blaizard/jardinier2000/README.md

# Jardinier 2000

# Getting started

To initialize and deploy the server, simply run:
```bash
./app.py update
./app.py init
./app.py start prod
```
