blaizard/jardinier2000/(list of files, cad)

Other CAD files:
nodes/water-provider/threads.scad
