blaizard/jardinier2000/nodes/observer/observer.brd

## EAGLE design nodes/observer/observer.brd (2019-12-02)

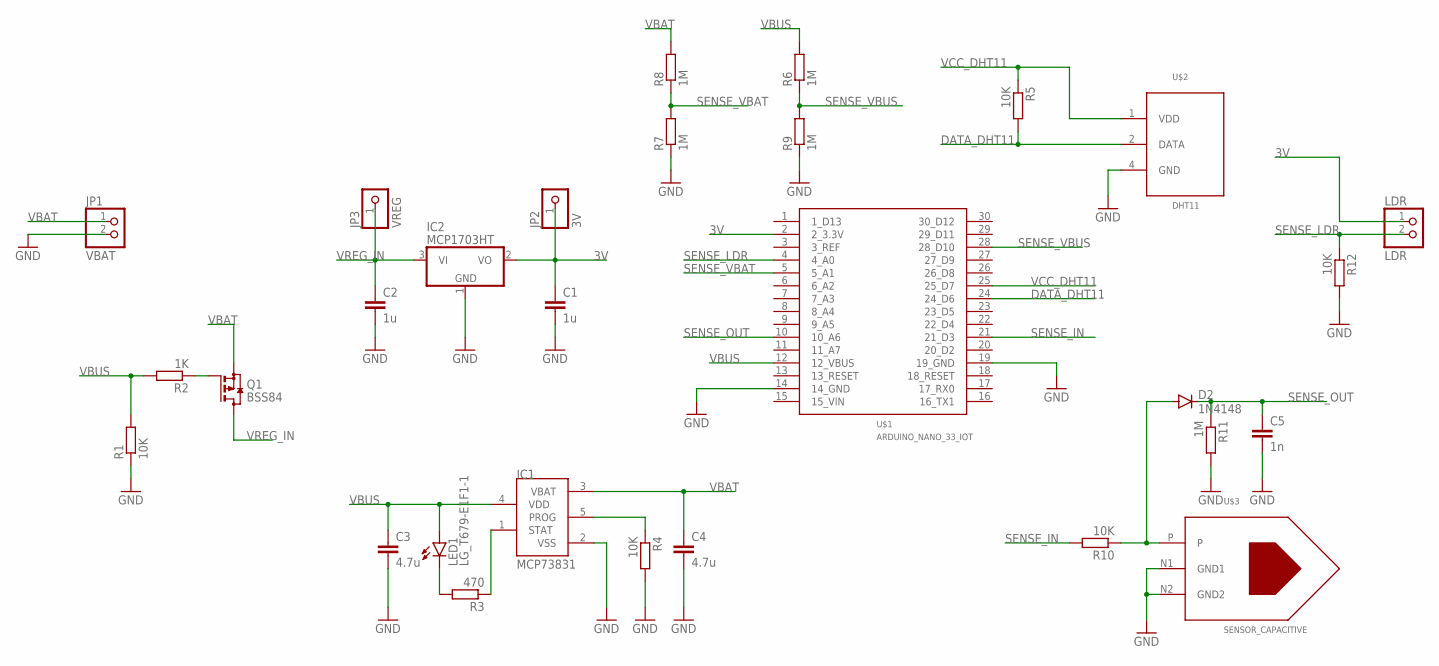
[picture p1: schematic observer.sch]

Parts:
C1, C2: 1u; C0805
C3, C4: 4.7u; C0805
C5: 1n; C0805
D2: 1N4148; MICROMELF-W
IC1: MCP73831; SOT23-5L
IC2: MCP1703HT; SOT23
JP1: VBAT; 1X02
JP2: 3V; 1X01
JP3: VREG; 1X01
LDR: LDR; 1X02
LED1: LG_T679-E1F1-1; PLCC2
Q1: BSS84; SOT23
R1, R4, R5, R10, R12: 10K; R0805
R2: 1K; R0805
R3: 470; R0805
R6, R7, R8, R9, R11: 1M; R0805
U$1: ARDUINO_NANO_33_IOT
U$2: DHT11
U$3: SENSOR_CAPACITIVE; SENSOR_CAPACITIVE_MOISTURE

Connections:
3V: C1.1, IC2.2 (VO), JP2.1, LDR.1, U$1.2 (2_3.3V)
DATA_DHT11: R5.2, U$1.24 (24_D6), U$2.2 (DATA)
GND: C1.2, C2.2, C3.2, C4.2, C5.2, IC1.2 (VSS), IC2.1 (GND), JP1.2, R1.1, R4.2, R7.1, R9.1, R11.2, R12.2, U$1.14 (14_GND), U$1.19 (19_GND), U$2.4 (GND), U$3.N1 (GND1), U$3.N2 (GND2)
unnamed: Q1.1 (G), R2.1
unnamed: LED1.C, R3.2
unnamed: IC1.1 (STAT), R3.1
unnamed: IC1.5 (PROG), R4.1
unnamed: D2.A, R10.1, U$3.P
SENSE_IN: R10.2, U$1.21 (21_D3)
SENSE_LDR: LDR.2, R12.1, U$1.4 (4_A0)
SENSE_OUT: C5.1, D2.C, R11.1, U$1.10 (10_A6)
SENSE_VBAT: R7.2, R8.1, U$1.5 (5_A1)
SENSE_VBUS: R6.1, R9.2, U$1.28 (28_D10)
VBAT: C4.1, IC1.3 (VBAT), JP1.1, Q1.2 (S), R8.2
VBUS: C3.1, IC1.4 (VDD), LED1.A, R1.2, R2.2, R6.2, U$1.12 (12_VBUS)
VCC_DHT11: R5.1, U$1.25 (25_D7), U$2.1 (VDD)
VREG_IN: C2.1, IC2.3 (VI), JP3.1, Q1.3 (D)

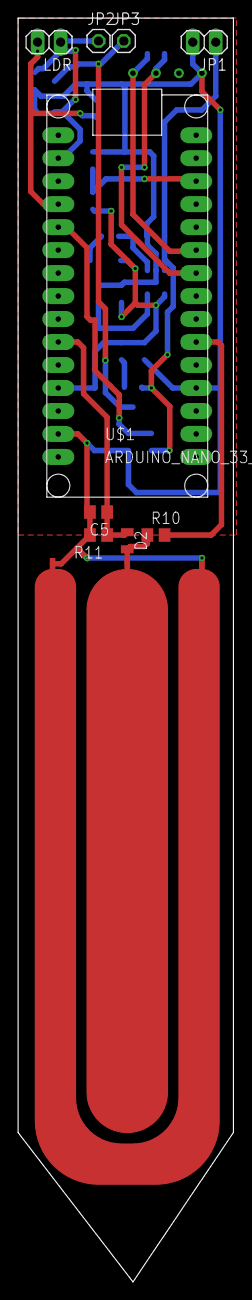
[picture p2: board observer.brd from above]

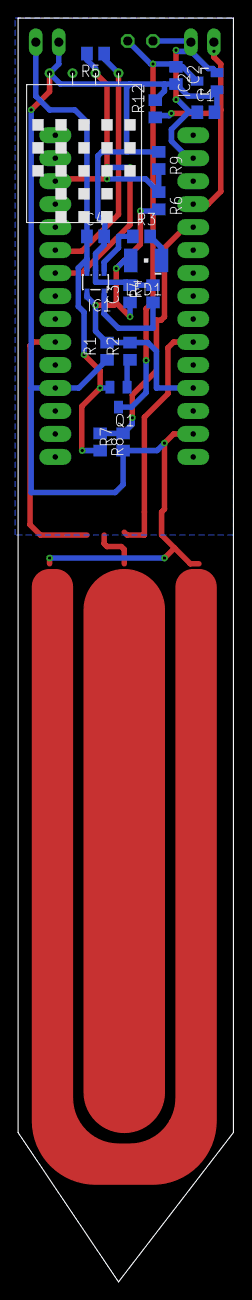
[picture p3: board observer.brd from below]

Board: 2 copper layers, 23.8 x 139.7 mm, 29 parts (19 on the bottom side), 17 nets.
