blaizard/jardinier2000/nodes/battery-management/battery.brd

## EAGLE design nodes/battery-management/battery.brd (2019-08-25)

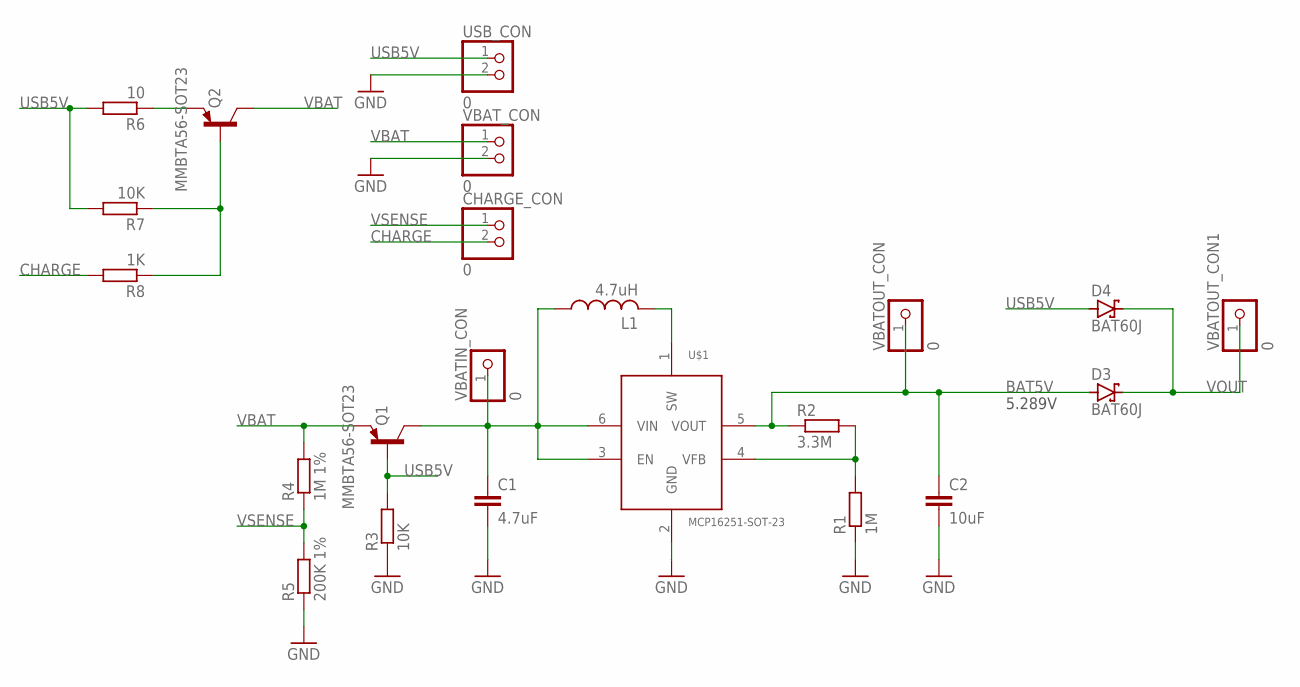
[picture p4: schematic battery.sch]

Parts:
C1: 4.7uF; C0805
C2: 10uF; C0805
CHARGE_CON: 0; 1X02
D3, D4: BAT60J; SOD323_ST
L1: 4.7uH; L4532P
Q1, Q2: MMBTA56-SOT23; SOT23
R1: 1M; R0805
R2: 3.3M; R0805
R3, R7: 10K; R0805
R4: 1M 1%; R0805
R5: 200K 1%; R0805
R6: 10; R0805
R8: 1K; R0805
U$1: MCP16251-SOT-23; SOT-23
USB_CON: 0; 1X02
VBATIN_CON: 0; 1X01
VBATOUT_CON, VBATOUT_CON1: 0; 1X01
VBAT_CON: 0; 1X02

Connections:
BAT5V: C2.1, D3.A, R2.1, U$1.5 (VOUT), VBATOUT_CON.1
CHARGE: CHARGE_CON.2, R8.2
GND: C1.2, C2.2, R1.1, R3.1, R5.1, U$1.2 (GND), USB_CON.2, VBAT_CON.2
unnamed: L1.2, U$1.1 (SW)
unnamed: R1.2, R2.2, U$1.4 (VFB)
unnamed: Q2.1 (B), R7.1, R8.1
unnamed: Q2.2 (E), R6.1
unnamed: C1.1, L1.1, Q1.3 (C), U$1.3 (EN), U$1.6 (VIN), VBATIN_CON.1
USB5V: D4.A, Q1.1 (B), R3.2, R6.2, R7.2, USB_CON.1
VBAT: Q1.2 (E), Q2.3 (C), R4.2, VBAT_CON.1
VOUT: D3.C, D4.C, VBATOUT_CON1.1
VSENSE: CHARGE_CON.1, R4.1, R5.2

Notes on the sheet:
5.289V

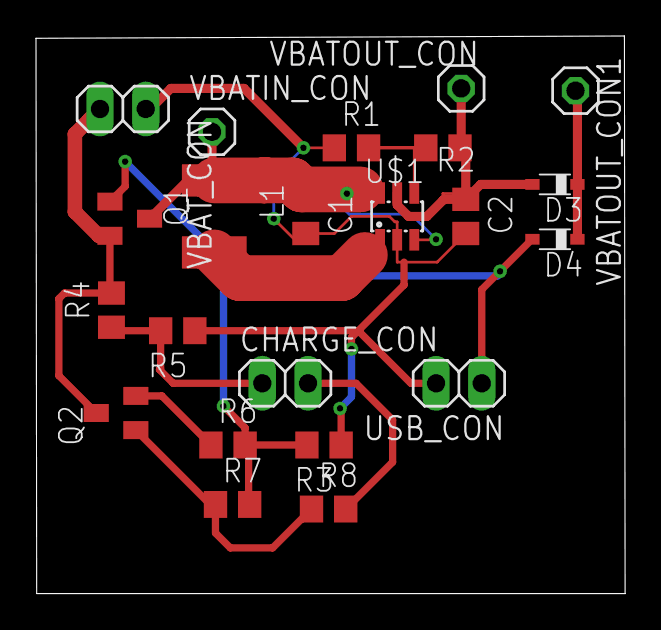
[picture p5: board battery.brd from above]

Board: 2 copper layers, 32.7 x 31.0 mm, 22 parts (0 on the bottom side), 12 nets.
