blaizard/jardinier2000/(commit log)

2019-08-08 Adding arduino node
2019-08-13 Adding moisture and luminosity sensors
2019-08-13 Adding sensor title
2019-08-25 Adding battery management
    [battery.brd, battery.sch, water-provider.scad]
2019-08-28 Begining of water provider scad design
    [threads.scad, water-provider.scad]
2019-12-02 Making new board
    [observer.brd, observer.sch, water-provider.scad]
2019-12-15 Adding batteryCC
